mpinnuck/dewcontroller-hardware/firmware/esp32s3-pinout.txt

/Users/markpinnuck/Library/Arduino15/packages/esp32/hardware/esp32/3.2.0/cores/esp32/Arduino.h

ArduinoIDE	GPIO	Pin
D0			1		1
D1			2		2
D2			3		3
D3			4		4
D4			5		5
D5			6		6
D6			43		7
D7			44		8
D8			7		9
D9			8		10
D10			9		11

Analog in
A0			1		1
A1			2		2
A2			3		3
A3			4		4
A4			5		5
A5			6		6
