mpinnuck/dewcontroller-hardware/hardware/mechanical/dewcontroller.FCStd

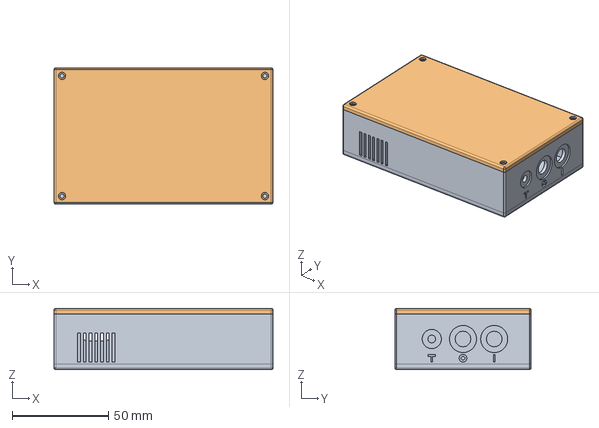
[picture p1: CAD file, 2025-06-08]
hardware/mechanical/dewcontroller.FCStd
114.0 x 71.0 x 32.0 mm
Base
Lid
