mpinnuck/dewcontroller-hardware/hardware/mechanical/stl/Base.stl

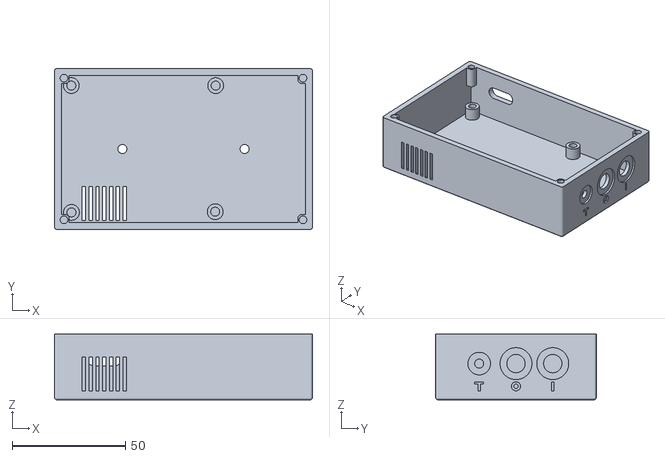
[picture p2: CAD file, 2025-06-08]
hardware/mechanical/stl/Base.stl
114.0 x 71.0 x 29.0
