mpinnuck/dewcontroller-hardware/hardware/mechanical/stl/Lid.stl

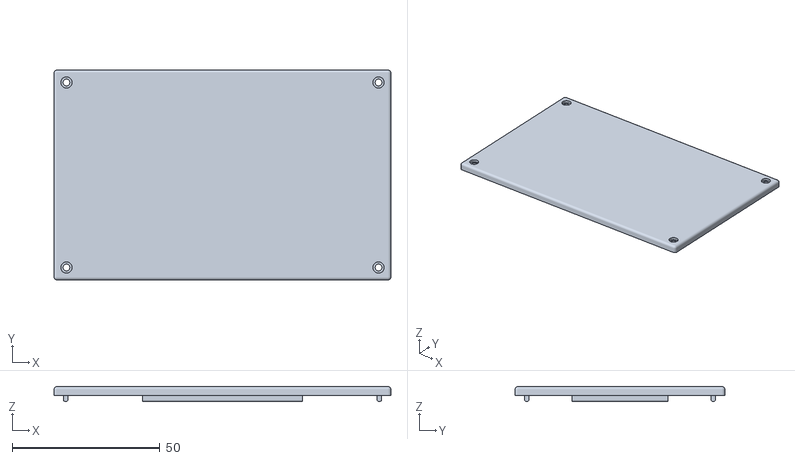
[picture p3: CAD file, 2025-06-08]
hardware/mechanical/stl/Lid.stl
114.0 x 71.0 x 5.00
