mpinnuck/dewcontroller-hardware/hardware/dewcontroller/dewcontroller.kicad_pcb

## KiCad design hardware/dewcontroller/dewcontroller.kicad_pcb (2025-06-08)

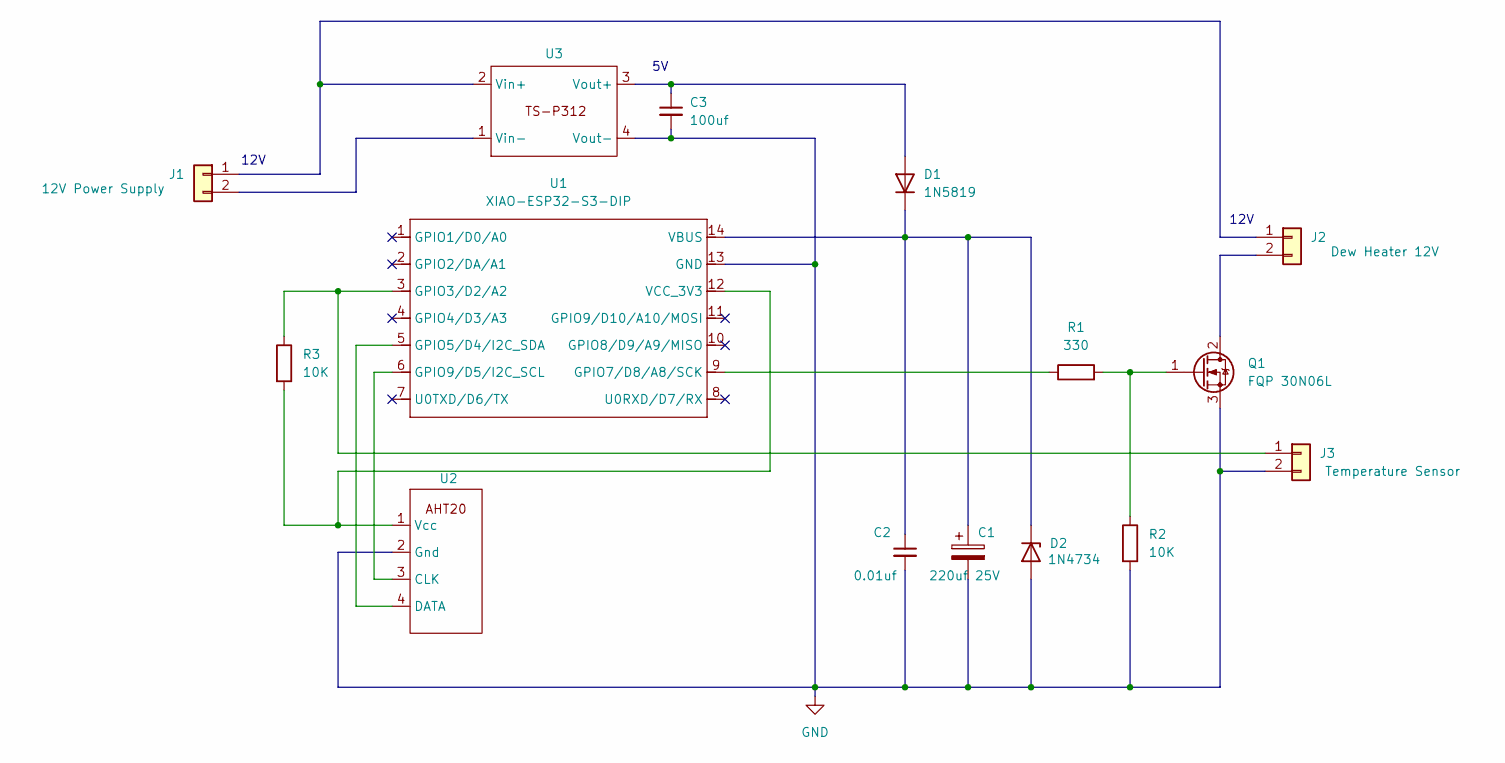
[picture p4: schematic dewcontroller.kicad_sch, Dew Heater Controller]

Parts:
C1: 220uf 25V; CP_Radial_D5.0mm_P2.00mm
C2: 0.01uf; C_Disc_D3.0mm_W1.6mm_P2.50mm
C3: 100uf; CP_Radial_D5.0mm_P2.00mm
D1: 1N5819; D_DO-41_SOD81_P7.62mm_Horizontal
D2: 1N4734; D_DO-41_SOD81_P7.62mm_Horizontal
J1: 12V Power Supply; JST_XH_B2B-XH-A_1x02_P2.50mm_Vertical
J2: Dew Heater 12V; JST_XH_B2B-XH-A_1x02_P2.50mm_Vertical
J3: Temperature Sensor; JST_XH_B2B-XH-A_1x02_P2.50mm_Vertical
Q1: FQP 30N06L; TO-220-3_Vertical
R1: 330; R_Axial_DIN0207_L6.3mm_D2.5mm_P10.16mm_Horizontal
R2, R3: 10K; R_Axial_DIN0207_L6.3mm_D2.5mm_P10.16mm_Horizontal
U1: XIAO-ESP32-S3-DIP; MCU_Seeed_ESP32C3_EdgeOnly
U2: AHT20
U3: Converter TS-P312 DC Buck

Connections:
GND: C1.2, C2.2, C3.2, D2.2 (A), J3.2, Q1.3 (S), R2.2, U1.13 (GND), U2.2 (Gnd), U3.4 (Vout-)
unnamed: C3.1, D1.2 (A), U3.3 (Vout+)
unnamed: C1.1, C2.1, D1.1 (K), D2.1 (K), U1.14 (VBUS)
unnamed: J1.1, J2.1 (12V), U3.2 (Vin+)
unnamed: J1.2, U3.1 (Vin-)
unnamed: J2.2 (Gnd), Q1.2 (D)
unnamed: J3.1, R3.1, U1.3 (GPIO3/D2/A2)
unnamed: Q1.1 (G), R1.2, R2.1
unnamed: U1.5 (GPIO5/D4/I2C_SDA), U2.4 (DATA)
unnamed: R1.1, U1.9 (GPIO7/D8/A8/SCK)
unnamed: U1.6 (GPIO9/D5/I2C_SCL), U2.3 (CLK)
unnamed: R3.2, U1.12 (VCC_3V3), U2.1 (Vcc)

Notes on the sheet:
12V

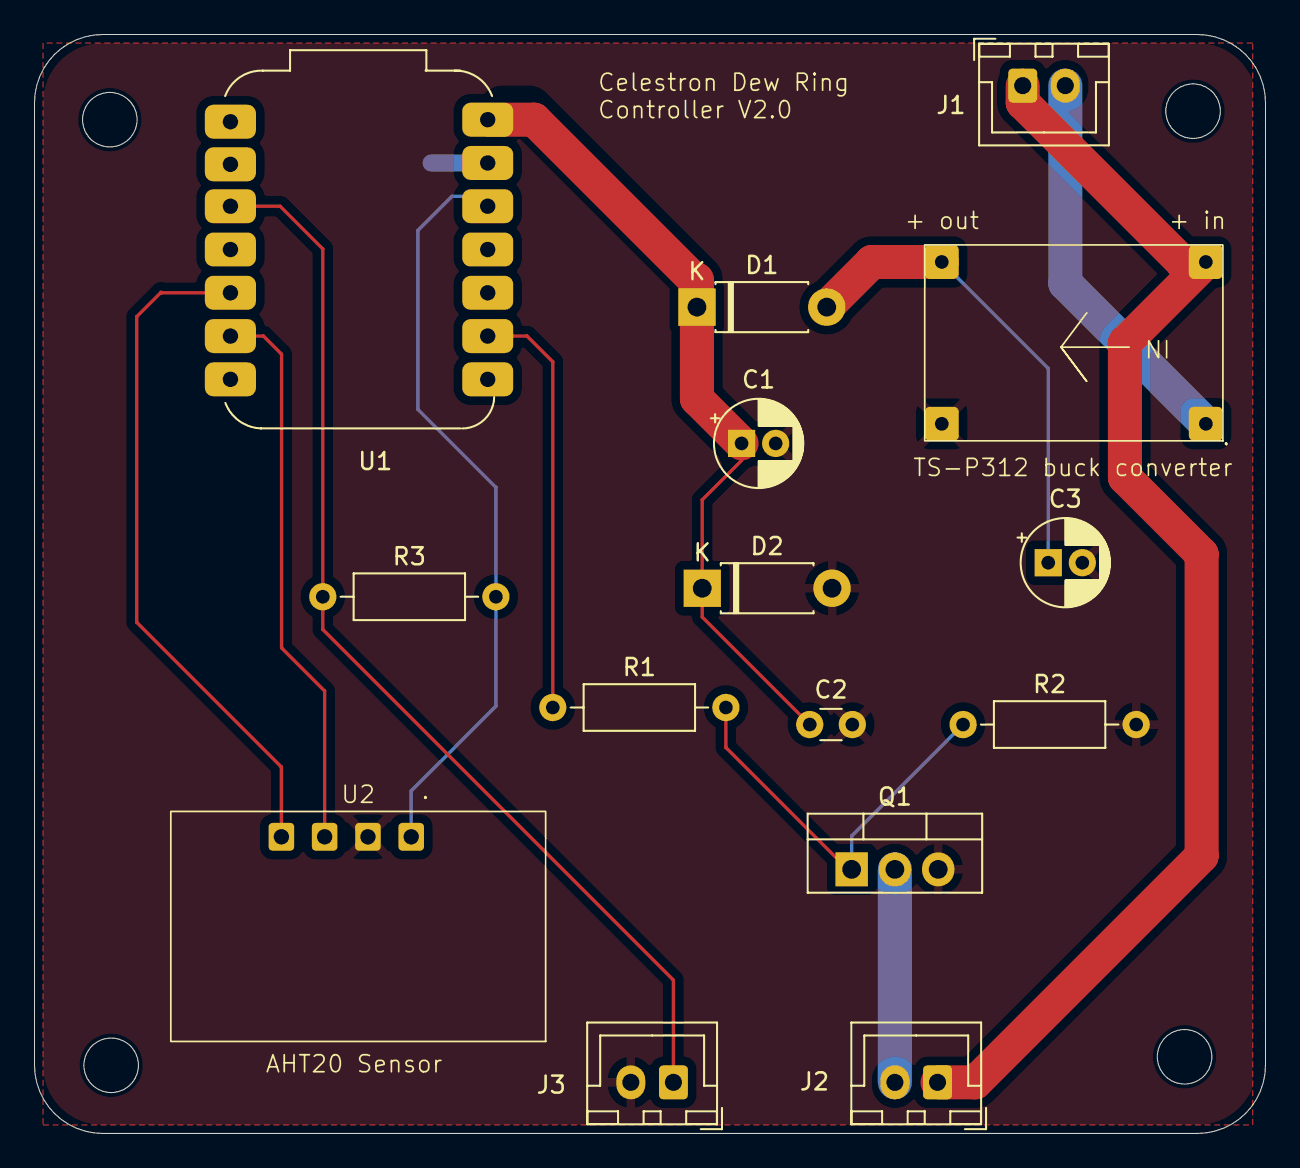
[picture p5: board dewcontroller.kicad_pcb from above]

Board: 2 copper layers, 72.3 x 64.5 mm, 15 parts (0 on the bottom side), 12 nets.
