mpinnuck/dewcontroller-hardware/(commit log)

2025-05-28 V3.2 turned led on when wifi connected
2025-06-08 v3.3. add LED control
2025-06-08 V3.4 mechanical and electrical
    [Base.stl, Lid.stl, dewcontroller.FCStd, dewcontroller.csv, dewcontroller.kicad_pcb, dewcontroller.kicad_sch]
2025-06-09 v3.5 add clear data, calibration continues until stopped more data
2025-06-10 v3.6 added new calibration strategy and version number
2025-06-11 V2 - added weather station and SHT40 sensor
2025-06-12 v2.1 toggle heater button text
2025-06-12 v2.2 improved heating algorithm
2025-07-05 V2.4d latest thermistor ambient temp data
    [dewcontrollerCallibration.csv]
2025-09-09 V2.6 dewspread of 3 triggers heater, not rh 80%
2025-11-13 v2.7.1 added background thread for long running tasks.
2025-11-24 v2.7.5 If no Wifi credentials go straight to AP mode. If Wifi credentials change reboot
    [dewcontroller.ino]
2025-12-18 v2.8.0 default sensor now AHT20 matches what is on the board
2025-12-29 v2.9.0 add SOURCE_WEATHER as fallback if SHT40 fails to initialize
    [dewcontroller.ino]
2026-03-22 V2.9.0a kicad update
2026-03-22 v3.0.0 fixed AP fallback
    [TempDewSensorTest.ino, dewcontroller.ino]
2026-04-04 V4.0.0 made thread safe, improved gheating algorithm fixed bugs
    [dewcontroller.ino]
2026-04-12 v4.1.0 fixed STA mode check in AP mode
    [dewcontroller.ino]
2026-05-12 Ignore KiCad lock files and .history directory
2026-05-12 v5.0.0 chaged heating algorithm to a spread table
